Niglou/FC_ESP32/doc/Schematic_FC_ESP32.pdf

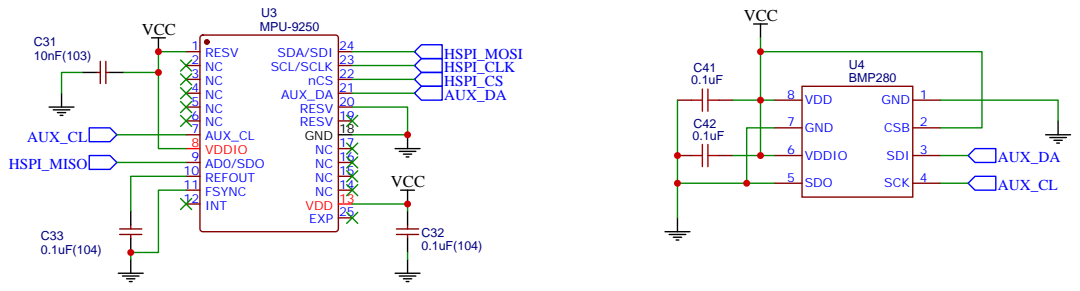
[picture p1: page 1]

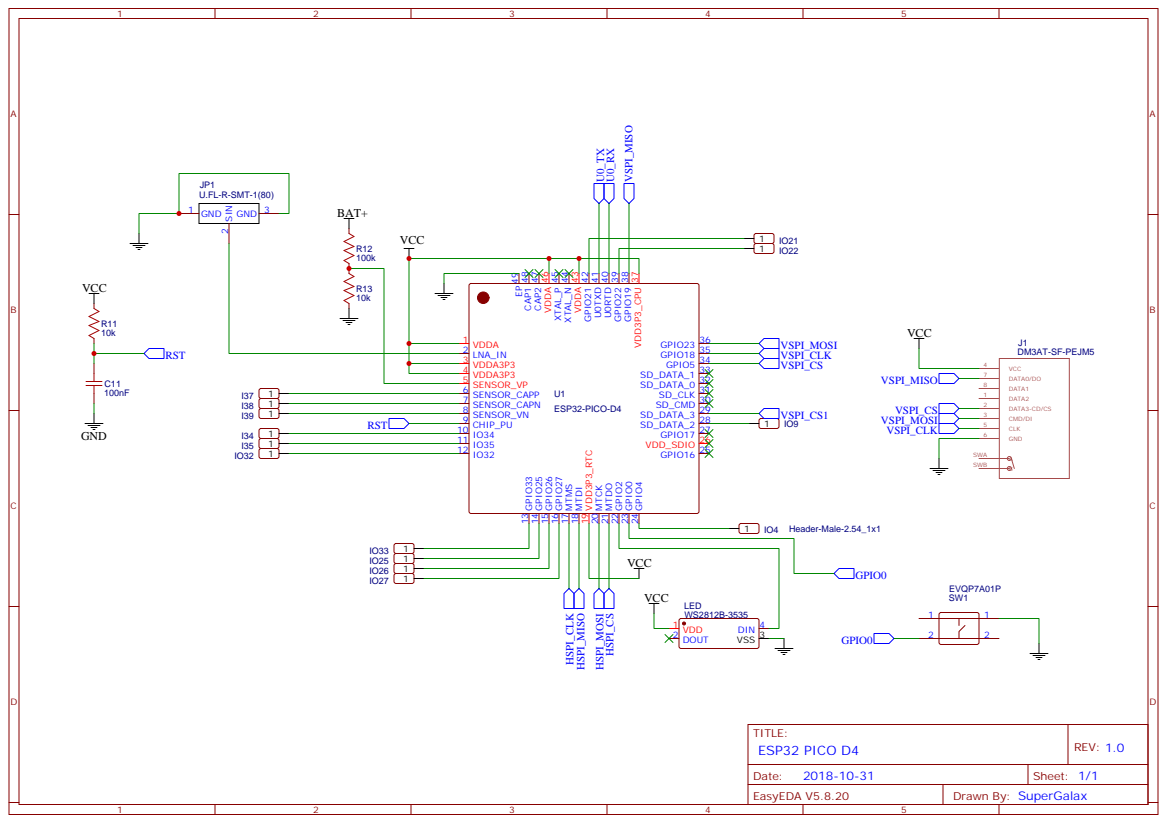
[picture p2: page 2]

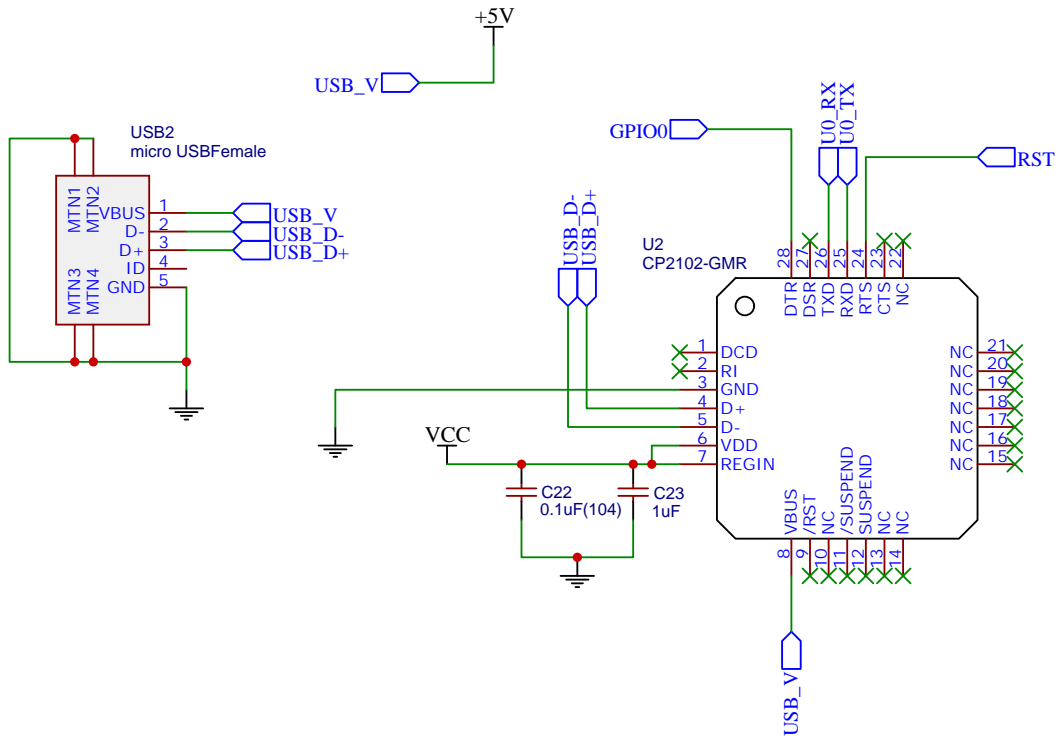
[picture p3: page 3]

NC 22 CTS 23 RTS 24 RXD 25 TXD 26 DSR 27 DTR 28

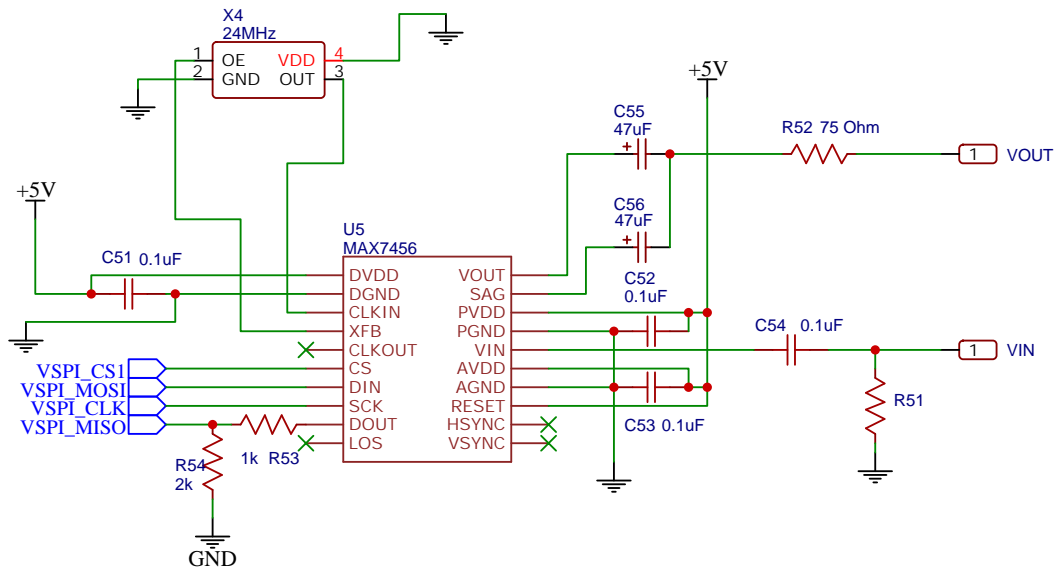
[picture p4: page 4]

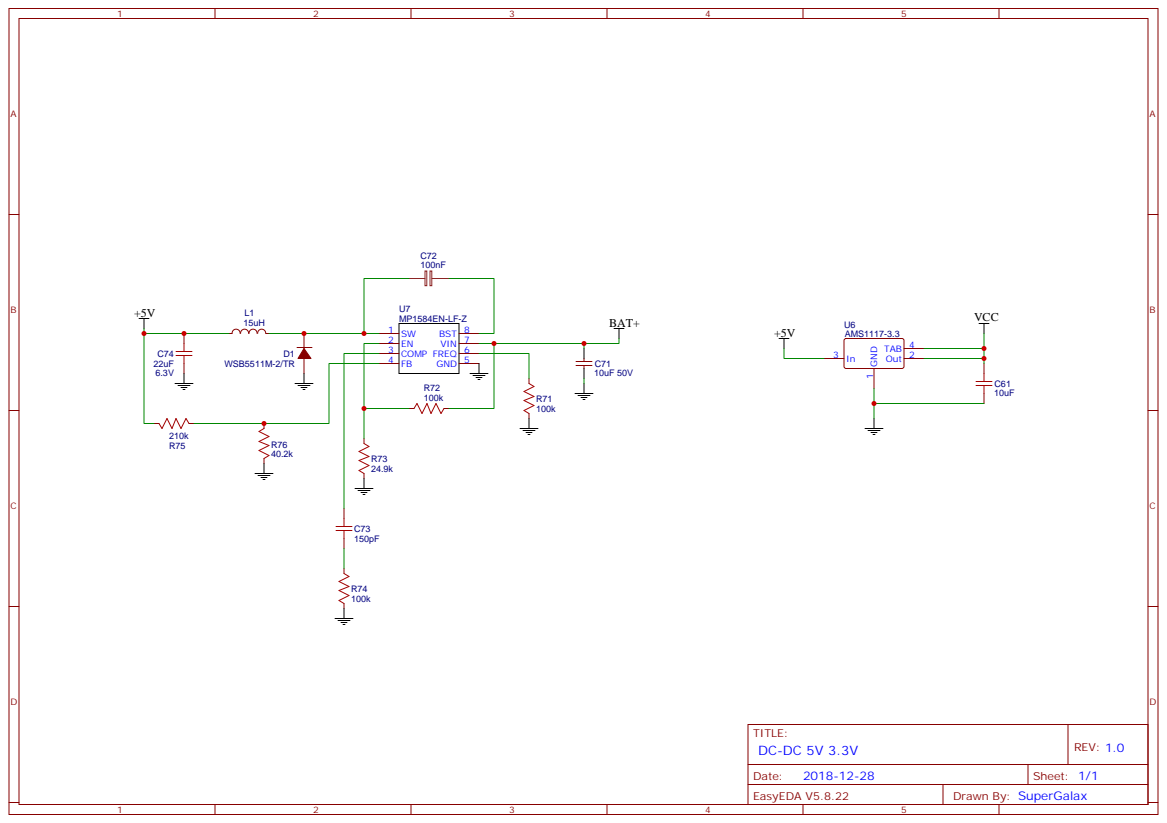
[picture p5: page 5]
