Niglou/FC_ESP32/(commit log)

2020-03-18 remove esp32 librairy and use esp32-nonos
2020-03-19 remove test motor lines
2020-03-25 add constructor and attach function
2020-04-01 change pwm and gpio include
2020-04-03 Add Schematics
2020-04-06 fix MAX7456 print function
    [max7456.cpp, max7456.h]
2020-04-07 update with spi addr_h
2020-04-10 add battery gpio init
2020-04-10 add battery voltage monitor and pt1 filter
2020-04-12 add reset function for MAX7456
    [max7456.cpp, max7456.h]
2020-04-12 set looptime to 4khz, change PID, print voltage
